Step7dk/Lampe/qi-lamp-charger.kicad_pcb

## KiCad design qi-lamp-charger.kicad_pcb (2022-11-14)

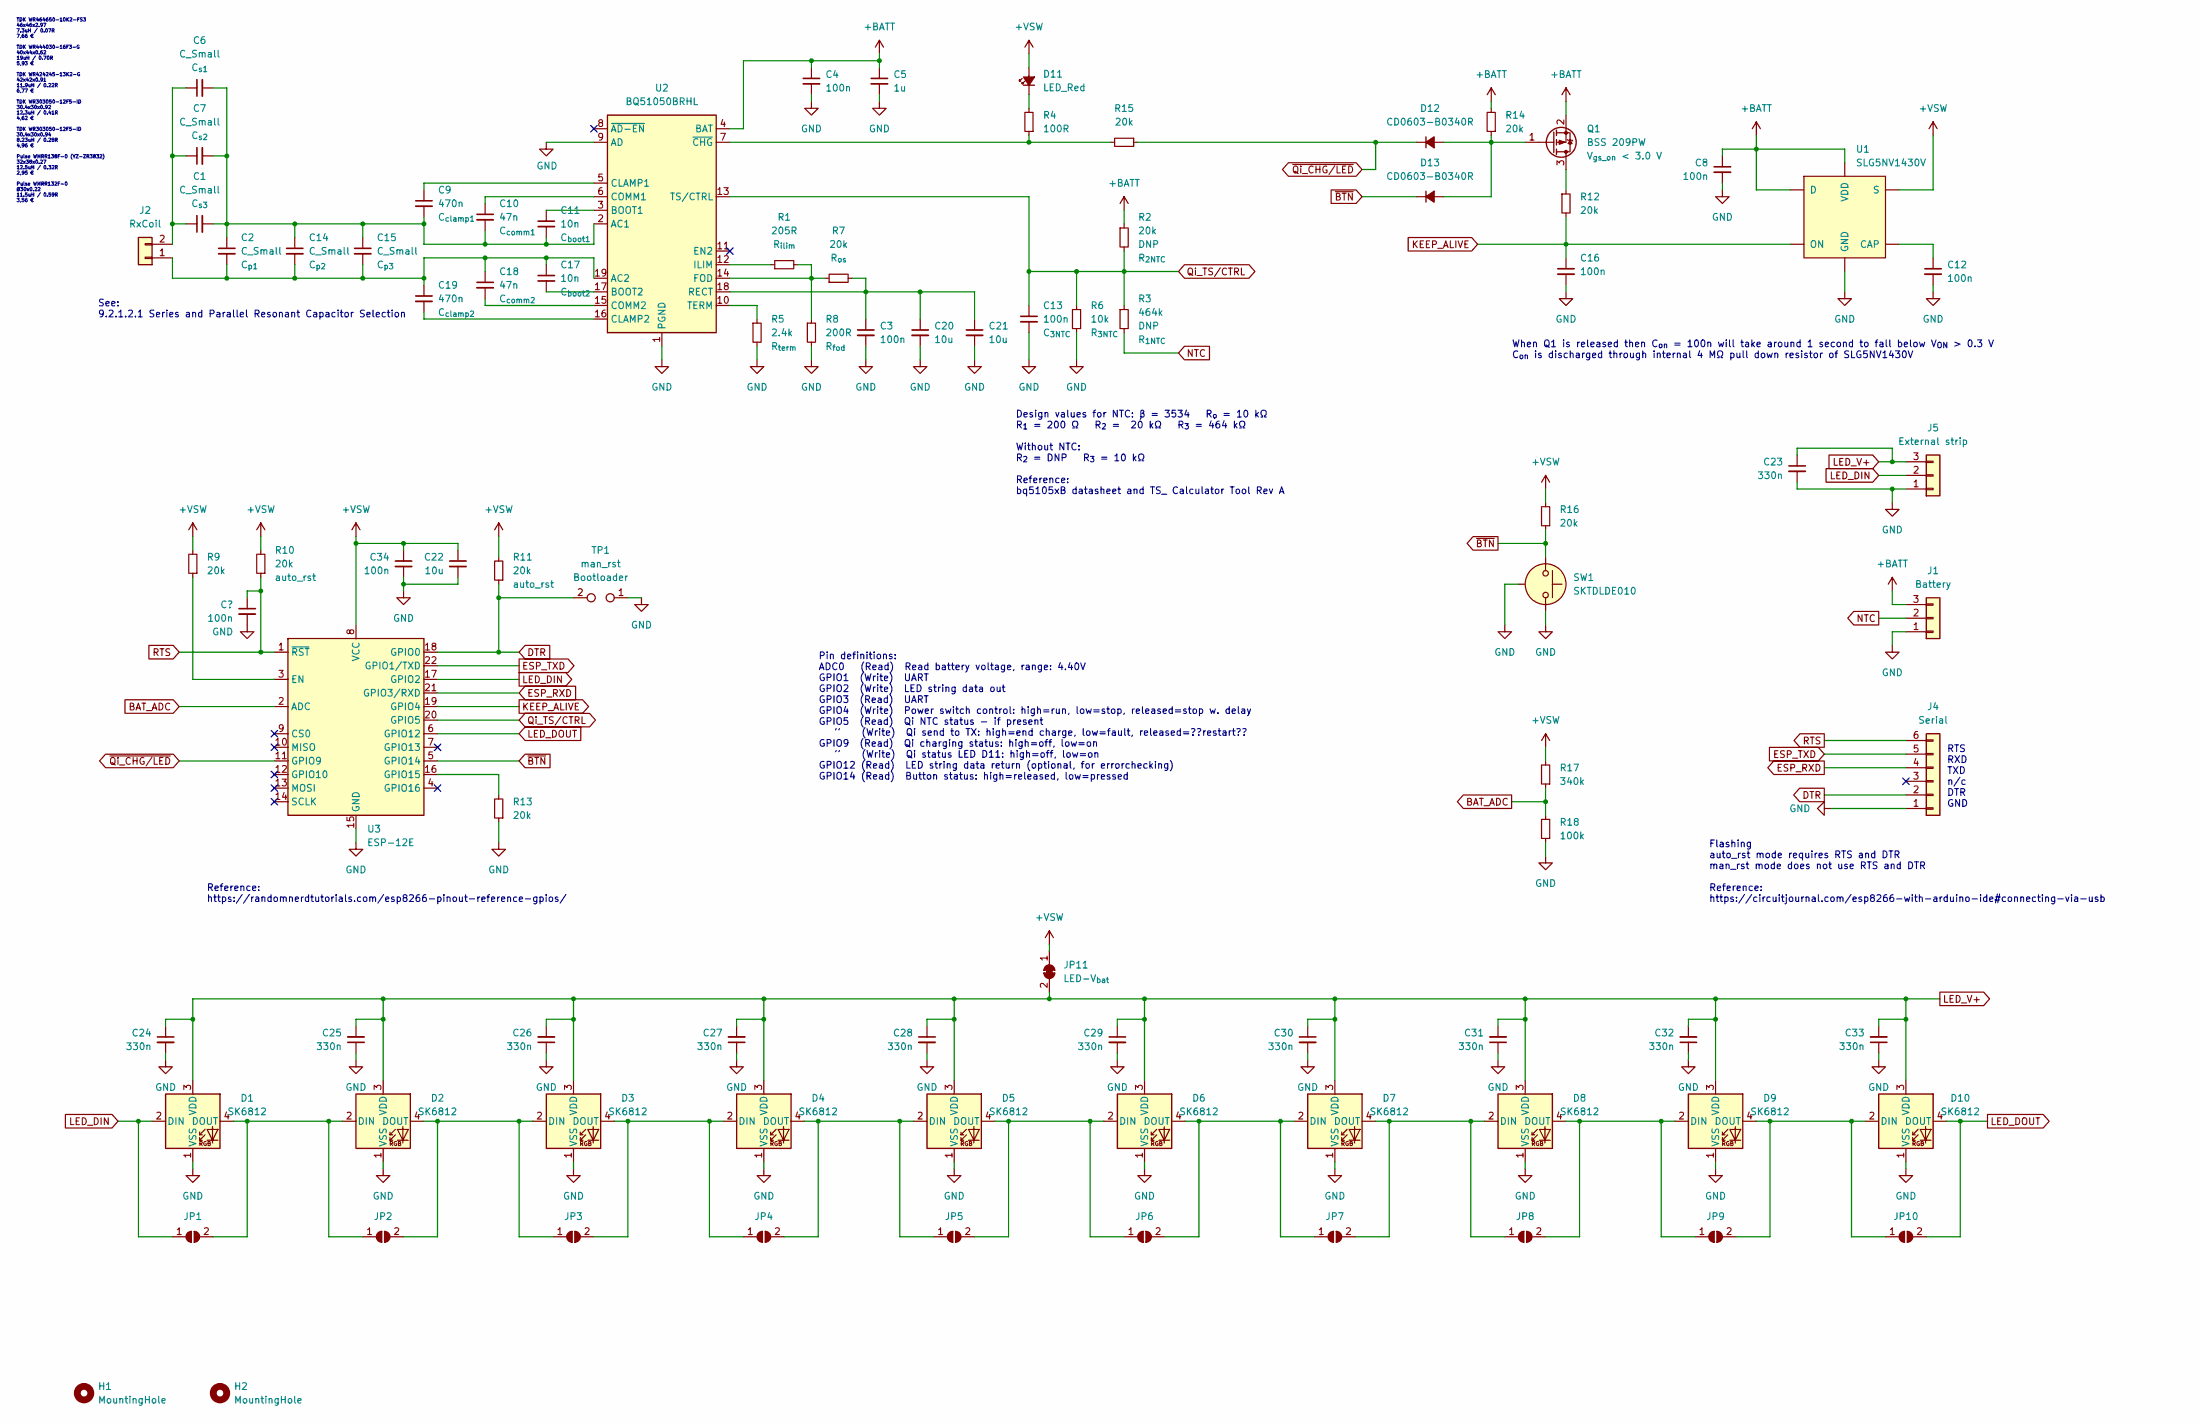
[picture p1: schematic qi-lamp-charger.kicad_sch, Main schematic]

Parts:
C1, C2, C6, C7, C14, C15: C_Small; C_0603_1608Metric; Rating 50V
C3, C4, C8, C12, C13, C16, C34: 100n; C_0603_1608Metric; Manufacturer_Part_Number CL10B104KO8NNND
C5: 1u; C_0603_1608Metric; Manufacturer_Part_Number CL10A105KO8NNNC
C9, C19: 470n; C_0603_1608Metric; Manufacturer_Part_Number CL10B474KO8NNNC
C10, C18: 47n; C_0603_1608Metric; Manufacturer_Part_Number CL10B473KO8NNND
C11, C17: 10n; C_0603_1608Metric; Manufacturer_Part_Number CL10B103KO8NNNC
C20, C21, C22: 10u; C_0805_2012Metric; Manufacturer_Part_Number CL21A106KOQNNNE
C23, C24, C25, C26, C27, C28, C29, C30, C31, C32, C33: 330n; C_0603_1608Metric; Manufacturer_Part_Number CL10B334KO8NNNC
D1, D2, D3, D4, D5, D6, D7, D8, D9, D10: SK6812; LED_SK6812_PLCC4_5.0x5.0mm_P3.2mm; Manufacturer_Part_Number SK6812
D11: LED_Red; LED_0603_1608Metric; Manufacturer_Part_Number LTST-C191KFKT
D12, D13: CD0603-B0340R; D_0603_1608Metric; Manufacturer_Part_Number CD0603-B0340R
H1, H2: MountingHole; MountingHole_2.2mm_M2
J1, J5: Conn_01x03; PinHeader_1x03_P2.54mm_Vertical
J2: Conn_01x02; PinHeader_1x02_P2.54mm_Vertical
J4: Conn_01x06; PinHeader_1x06_P2.54mm_Vertical
JP1, JP2, JP3, JP4, JP5, JP6, JP7, JP8, JP9, JP10: SolderJumper_2_Open; SolderJumper-2_P1.3mm_Open_RoundedPad1.0x1.5mm
JP11: SolderJumper_2_Bridged; SolderJumper-2_P1.3mm_Bridged_RoundedPad1.0x1.5mm
Q1: BSS 209PW; SOT-23; Rating V_{gs_on} < 3.0 V; Manufacturer_Part_Number BSS209PWH6327XTSA1
R1: 205R; R_0603_1608Metric; Manufacturer_Part_Number ERJ-3EKF2050V
R2, R7, R9, R10, R11, R12, R13, R14, R15, R16: 20k; R_0603_1608Metric; Manufacturer_Part_Number ERJ-3EKF2002V
R3: 464k; R_0603_1608Metric; Manufacturer_Part_Number ERJ-3EKF4643V
R4: 100R; R_0603_1608Metric; Manufacturer_Part_Number ERJ-3EKF1000V
R5: 2.4k; R_0603_1608Metric; Manufacturer_Part_Number ERJ-3EKF2401V
R6: 10k; R_0603_1608Metric; Manufacturer_Part_Number ERJ-3EKF1002V
R8: 200R; R_0603_1608Metric; Manufacturer_Part_Number ERJ-3EKF2000V
R17: 340k; R_0603_1608Metric; Manufacturer_Part_Number ERJ-3EKF3403V
R18: 100k; R_0603_1608Metric; Manufacturer_Part_Number ERJ-3EKF1003V
SW1: SKTDLDE010; Manufacturer_Part_Number SKTDLDE010
TP1: TestPoint_2Pole; PinHeader_1x02_P1.27mm_Vertical
U1: SLG5NV1430V; TDFN-8_1.5x2.0mm_P0.5mm (Fused Lead); Manufacturer_Part_Number SLG5NV1430V
U2: BQ51050BRHL; Texas_VQFN-RHL-20; Manufacturer_Part_Number BQ51050BRHLR
U3: ESP-12E

Connections:
+BATT: C4.1, C5.1, C8.1, J1.3, Q1.2 (S), R2.1, R14.2, U1.1 (VDD), U1.3 (D), U1.4 (D), U2.4 (BAT)
+VSW: C22.1, C34.1, D11.2 (A), JP11.1 (A), R9.2, R10.2, R11.2, R16.2, R17.2, U1.5 (S), U1.6 (S), U3.8 (VCC)
BAT_ADC: R17.1, R18.2, U3.2 (ADC)
DTR: J4.2, R11.1, TP1.2, U3.18 (GPIO0)
ESP_RXD: J4.4, U3.21 (GPIO3/RXD)
ESP_TXD: J4.5, U3.22 (GPIO1/TXD)
GND: C3.2, C4.2, C5.2, C8.2, C12.2, C13.2, C16.2, C20.2, C21.2, C22.2, C23.2, C24.2, C25.1, C26.1, C27.1, C28.2, C29.2, C30.2, C31.1, C32.1, C33.1, C34.2, D1.1 (VSS), D2.1 (VSS), D3.1 (VSS), D4.1 (VSS), D5.1 (VSS), D6.1 (VSS), D7.1 (VSS), D8.1 (VSS), D9.1 (VSS), D10.1 (VSS), J1.1, J4.1, J5.1, R5.2, R6.2, R8.2, R13.1, R18.1, SW1.1, SW1.3, TP1.1, U1.8 (GND), U2.1 (PGND), U2.9 (AD), U2.20 (PGND), U2.21 (PGND), U3.15 (GND)
KEEP_ALIVE: C16.1, R12.2, U1.2 (ON), U3.19 (GPIO4)
LED_DIN: D1.2 (DIN), J5.2, JP1.1 (A), U3.17 (GPIO2)
LED_DOUT: D10.4 (DOUT), JP10.2 (B), U3.6 (GPIO12)
LED_V+: C23.1, C24.1, C25.2, C26.2, C27.2, C28.1, C29.1, C30.1, C31.2, C32.2, C33.2, D1.3 (VDD), D2.3 (VDD), D3.3 (VDD), D4.3 (VDD), D5.3 (VDD), D6.3 (VDD), D7.3 (VDD), D8.3 (VDD), D9.3 (VDD), D10.3 (VDD), J5.3, JP11.2 (B)
NTC: J1.2, R3.2
unnamed: C1.1, C6.1, C7.1, J2.2
unnamed: C1.2, C2.1, C6.2, C7.2, C9.2, C10.2, C11.2, C14.1, C15.1, U2.2 (AC1)
unnamed: C9.1, U2.5 (CLAMP1)
unnamed: C10.1, U2.6 (COMM1)
unnamed: C11.1, U2.3 (BOOT1)
unnamed: C12.1, U1.7 (CAP)
unnamed: C2.2, C14.2, C15.2, C17.1, C18.1, C19.1, J2.1, U2.19 (AC2)
unnamed: C17.2, U2.17 (BOOT2)
unnamed: C18.2, U2.15 (COMM2)
unnamed: C19.2, U2.16 (CLAMP2)
unnamed: C3.1, C20.1, C21.1, R7.2, U2.18 (RECT)
unnamed: D1.4 (DOUT), D2.2 (DIN), JP1.2 (B), JP2.1 (A)
unnamed: D2.4 (DOUT), D3.2 (DIN), JP2.2 (B), JP3.1 (A)
unnamed: D3.4 (DOUT), D4.2 (DIN), JP3.2 (B), JP4.1 (A)
unnamed: D4.4 (DOUT), D5.2 (DIN), JP4.2 (B), JP5.1 (A)
unnamed: D5.4 (DOUT), D6.2 (DIN), JP5.2 (B), JP6.1 (A)
unnamed: D6.4 (DOUT), D7.2 (DIN), JP6.2 (B), JP7.1 (A)
unnamed: D7.4 (DOUT), D8.2 (DIN), JP7.2 (B), JP8.1 (A)
unnamed: D8.4 (DOUT), D9.2 (DIN), JP8.2 (B), JP9.1 (A)
unnamed: D9.4 (DOUT), D10.2 (DIN), JP9.2 (B), JP10.1 (A)
unnamed: D11.1 (K), R4.2
unnamed: D12.2 (A), D13.2 (A), Q1.1 (G), R14.1
unnamed: Q1.3 (D), R12.1
unnamed: R1.1, U2.12 (ILIM)
unnamed: R1.2, R7.1, R8.1, U2.14 (FOD)
unnamed: R5.1, U2.10 (TERM)
unnamed: R9.1, U3.3 (EN)
unnamed: R13.2, U3.16 (GPIO15)
unnamed: R4.1, R15.2, U2.7 (~CHG)
Qi_TS/CTRL: C13.1, R2.2, R3.1, R6.1, U2.13 (TS/CTRL), U3.20 (GPIO5)
RTS: J4.6, R10.1, U3.1 (~RST)
~BTN: D13.1 (K), R16.1, SW1.2, U3.5 (GPIO14)
~Qi_CHG/LED: D12.1 (K), R15.1, U3.11 (GPIO9)

Notes on the sheet:
Reference: https://randomnerdtutorials.com/esp8266-pinout-reference-gpios/
TDK WR464650-10K2-FS3 46x46x2.97 7.3uH / 0.07R 7,66 € TDK WR444030-16F3-G 40x44x0.62 19uH / 0.70R 5,93 € TDK WR424245-13K2-G 42x42x0.91 11.9uH / 0.22R 6,77 € TDK WR303050-12F5-ID 30.4x30x0.92 12.3uH / 0.41R 4,62 € TDK WR303050-12F5-ID 30.4x30x0.94 8.23uH / 0.28R 4,96 € Pulse WMRR138F-0 (YZ-ZR3832) 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
Flashing auto_rst mode requires RTS and DTR man_rst mode does not use RTS and DTR Reference: https://circuitjournal.com/esp8266-with-arduino-ide#connecting-via-usb
Design values for NTC: β = 3534 R_{o} = 10 kΩ R_{1} = 200 Ω R_{2} = 20 kΩ R_{3} = 464 kΩ Without NTC: R_{2} = DNP R_{3} = 10 kΩ Reference: bq5105xB datasheet and TS_ Calculator Tool Rev A
See: 9.2.1.2.1 Series and Parallel Resonant Capacitor Selection
When Q1 is released then C_{on} = 100n will take around 1 second to fall below V_{ON} > 0.3 V C_{on} is discharged through internal 4 MΩ pull down resistor of SLG5NV1430V
RTS RXD TXD n/c DTR GND
Pin definitions: ADC0 (Read) Read battery voltage, range: 4.40V GPIO1 (Write) UART GPIO2 (Write) LED string data out GPIO3 (Read) UART GPIO4 (Write) Power switch control: high=run, low=stop, released=stop w. delay GPIO5 (Read) Qi NTC status - if present '' (Write) Qi send to TX: high=end charge, lo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

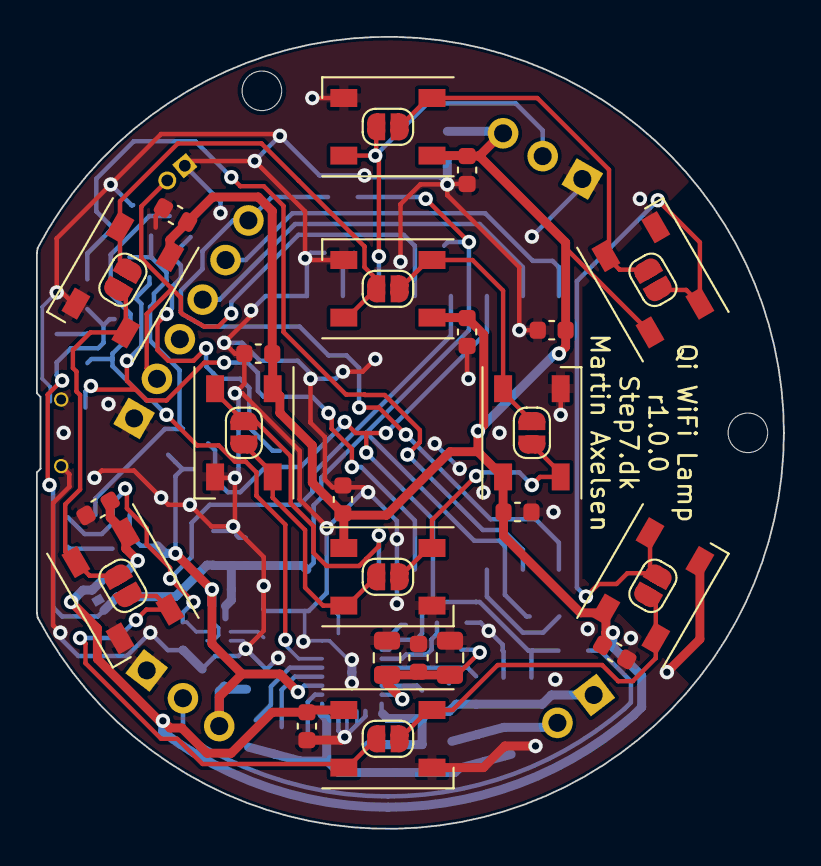
[picture p2: board qi-lamp-charger.kicad_pcb from above]

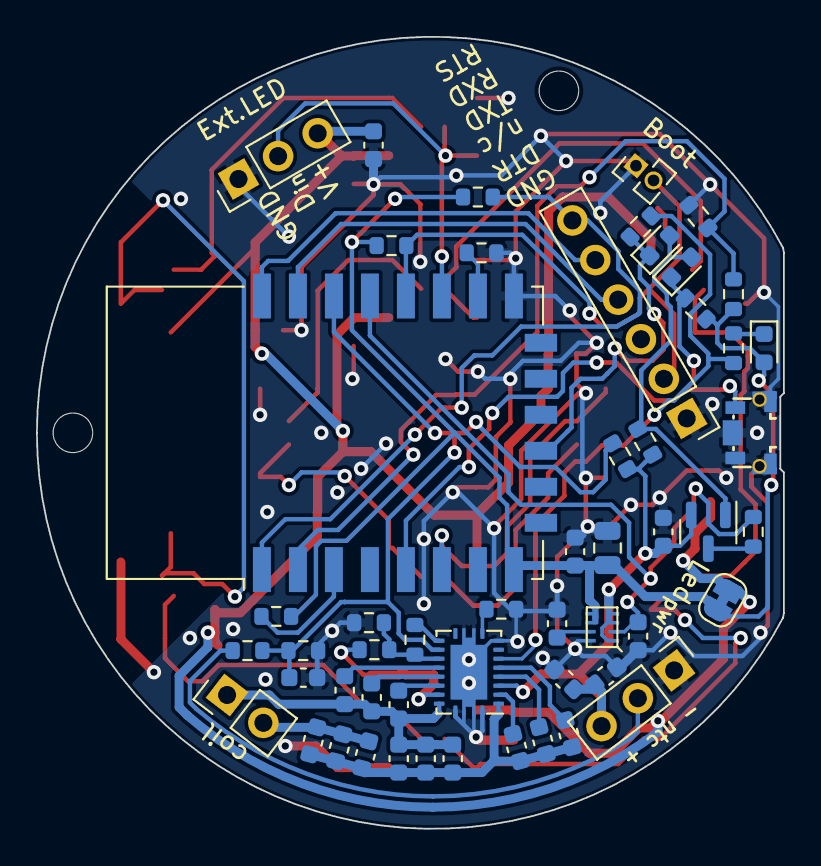
[picture p3: board qi-lamp-charger.kicad_pcb from below]

Board: 2 copper layers, 41.5 x 44.0 mm, 88 parts (53 on the bottom side), 45 nets.
