Step7dk/Lampe/(commit log)

2022-05-12 Set up Qi schematic
    [qi-lamp-charger.kicad_sch]
2022-05-12 add esp8266
    [Qi_receiver.kicad_sch, qi-lamp-charger.kicad_sch]
2022-05-16 Add power switch & LED's & ESP_GPIO's
    [Qi_receiver.kicad_sch, qi-lamp-charger.kicad_sch]
2022-05-16 Schematic done - missing just two footprints
    [qi-lamp-charger.kicad_sch]
2022-05-17 Redraw Button/DTR/GPIO0 complex & assign footprints
    [qi-lamp-charger.kicad_sch]
2022-05-17 Layout proposal 1
    [qi-lamp-charger.kicad_pcb, qi-lamp-charger.kicad_sch]
2022-05-18 Layout proposal 2
    [qi-lamp-charger.kicad_pcb]
2022-05-18 Layout Qi
    [qi-lamp-charger.kicad_pcb]
2022-05-18 Modules built
    [qi-lamp-charger.kicad_pcb, qi-lamp-charger.kicad_sch]
2022-05-18 Moving in
    [qi-lamp-charger.kicad_pcb, qi-lamp-charger.kicad_sch]
2022-05-19 Puzzling #2
    [qi-lamp-charger.kicad_pcb, qi-lamp-charger.kicad_sch]
2022-05-19 Puzzling #3
    [qi-lamp-charger.kicad_pcb, qi-lamp-charger.kicad_sch]
2022-05-19 Puzzling #4
    [qi-lamp-charger.kicad_pcb, qi-lamp-charger.kicad_sch]
2022-05-19 Puzzle #4 - has GPIO0 brainfart
    [qi-lamp-charger.kicad_pcb, qi-lamp-charger.kicad_sch]
2022-05-20 Puzzle #5
    [qi-lamp-charger.kicad_pcb, qi-lamp-charger.kicad_sch]
2022-05-20 Shematic changed
    [qi-lamp-charger.kicad_pcb, qi-lamp-charger.kicad_sch]
2022-05-21 Minor corrections to layout (not up to date with previous commit)
    [qi-lamp-charger.kicad_pcb]
2022-05-21 Puzzle #6
    [qi-lamp-charger.kicad_pcb, qi-lamp-charger.kicad_sch]
2022-05-22 Puzzle #7
    [qi-lamp-charger.kicad_pcb]
2022-05-22 Puzzle complete incl. DRC
    [qi-lamp-charger.kicad_pcb]
2022-05-23 Add info
    [qi-lamp-charger.kicad_sch]
2022-05-23 As ordered
    [qi-lamp-charger-B_Cu.gbr, qi-lamp-charger-B_Mask.gbr, qi-lamp-charger-B_Paste.gbr, qi-lamp-charger-B_Silkscreen.gbr, qi-lamp-charger-Edge_Cuts.gbr, qi-lamp-charger-F_Cu.gbr, qi-lamp-charger-F_Mask.gbr, qi-lamp-charger-F_Paste.gbr]
2022-05-24 Add one chip 3D model
    [qi-lamp-charger.kicad_pcb]
2022-06-03 PCBA r1.0 setup
    [qi-lamp-charger.kicad_pcb, qi-lamp-charger.kicad_sch]
2022-10-19 update pin description
    [qi-lamp-charger.kicad_sch]
2022-11-14 Improve text readability
    [qi-lamp-charger.kicad_sch]
2022-11-14 add reset cap in sch & bump to t1.0.999
    [qi-lamp-charger.kicad_sch]
2022-11-14 outline retract at button
    [qi-lamp-charger.kicad_pcb]
